saywha90/Bachelor_prosjekt/src/calibration/10_bin_calibration.py

"""
Interactive rear-bin route fine-tuning for real hardware calibration.

This tool edits the production route schema in ``bin_calibration.json`` for the
two physical rear bins only: ``RED_BIN`` and ``BLUE_BIN``.  It intentionally does
not create or save ``REJECT_BIN`` because production should return to scanning
when no object is gripped instead of routing to a reject bin.

The default mode connects to the arm, mirrors the touch-calibration workflow,
and supports explicit hardware movement plus limp-mode pose capture.  Offline
editing and test runs are still available with ``--dry-run``/``--no-hardware``.

Usage
-----
    PYTHONPATH=src python3 src/calibration/10_bin_calibration.py
    PYTHONPATH=src python3 src/calibration/10_bin_calibration.py --port /dev/cu.usbmodem101
    PYTHONPATH=src python3 src/calibration/10_bin_calibration.py --dry-run

Author: Bachelor Project 2026 – Autonomia    
"""

from __future__ import annotations

import argparse
import copy
import json
import os
import sys
import tempfile
import time
from dataclasses import dataclass
from datetime import date
from pathlib import Path
from typing import Any, Callable

sys.path.insert(0, os.path.join(os.path.dirname(os.path.abspath(__file__)), ".."))

import cv2  # noqa: E402
import numpy as np  # noqa: E402

from config.arm import (  # noqa: E402
    BIN_CALIBRATION_FILE as CONFIG_BIN_CALIBRATION_FILE,
    DEFAULT_REAR_ROUTE_BASE_YAW_LIMIT_DEG,
    SCAN_POSE,
    RouteCalibrationError,
    load_transport_route_calibration,
)
from ik.solver import ArmIK  # noqa: E402
from simulation.bin_safety import (  # noqa: E402
    BinVolume,
    SAG_AWARE_BIN_CLEARANCE_CM,
    bin_volumes_from_centres,
    find_claw_bin_point_clearance_violation,
    find_claw_bin_segment_clearance_violation,
    format_claw_bin_clearance_reason,
)


BIN_CALIBRATION_FILE = Path(CONFIG_BIN_CALIBRATION_FILE)
SERIAL_PORT = "/dev/cu.usbmodem101"
SERIAL_BAUD = 115200
MOVE_SETTLE_SECONDS = 0.75
ROUTE_SETTLE_SECONDS = 0.75
LIMP_MOTOR_IDS = (1, 2, 3, 4)
MAX_CAPTURE_M4_OFFSET = 1500
M4_STEPS_PER_REV = ArmIK.STEPS_PER_REV

ROUTE_SCHEMA_VERSION = 4
ONLY_BIN_NAMES = ("RED_BIN", "BLUE_BIN")
SHARED_WAYPOINTS = ("front_neutral", "rear_transfer", "rear_return_lift")
BIN_POSES = ("drop",)
POSE_FIELDS = ("x", "y", "z", "m4_offset")


@dataclass(frozen=True)
class WaypointSpec:
    """Editable route waypoint descriptor."""

    key: str
    title: str
    intent: str
    root: str
    bin_name: str | None = None
    pose_name: str | None = None


EDITABLE_WAYPOINTS = (
    WaypointSpec("front_neutral", "front_neutral", "carry", "shared"),
    WaypointSpec("rear_transfer", "rear_transfer", "rear_place", "shared"),
    WaypointSpec("rear_return_lift", "rear_return_lift", "rear_place", "shared"),
    WaypointSpec("RED_BIN.drop", "RED_BIN.drop", "rear_place", "bin", "RED_BIN", "drop"),
    WaypointSpec("BLUE_BIN.drop", "BLUE_BIN.drop", "rear_place", "bin", "BLUE_BIN", "drop"),
)


def _safe_default_route_schema() -> dict[str, Any]:
    """Return a conservative valid two-bin rear route schema."""

    return {
        "schema_version": ROUTE_SCHEMA_VERSION,
        "calibration_date": date.today().isoformat(),
        "calibrated_with_scan_pose": {k: int(v) for k, v in SCAN_POSE.items()},
        "rear_base_yaw_limit_deg": float(DEFAULT_REAR_ROUTE_BASE_YAW_LIMIT_DEG),
        "shared_waypoints": {
            "front_neutral": {
                "x": 22.0,
                "y": 0.0,
                "z": 30.0,
                "m4_offset": 0,
                "skip_sag": True,
            },
            "rear_transfer": {
                "x": -22.0,
                "y": 0.0,
                "z": 38.0,
                "m4_offset": 0,
                "skip_sag": True,
            },
            "rear_return_lift": {
                "x": -22.0,
                "y": 0.0,
                "z": 42.0,
                "m4_offset": 0,
                "skip_sag": True,
            },
        },
        "bins": {
            "RED_BIN": {
                "drop": {
                    "x": -24.0,
                    "y": -7.0,
                    "z": 37.0,
                    "m4_offset": 0,
                    "skip_sag": True,
                },
            },
            "BLUE_BIN": {
                "drop": {
                    "x": -24.0,
                    "y": 7.0,
                    "z": 37.0,
                    "m4_offset": 0,
                    "skip_sag": True,
                },
            },
        },
    }


def _route_calibration_to_schema(route_calibration: Any) -> dict[str, Any]:
    """Convert a validated config.arm transport route to writable JSON data."""

    def pose_to_dict(pose: Any) -> dict[str, Any]:
        return {
            "x": round(float(pose.x), 2),
            "y": round(float(pose.y), 2),
            "z": round(float(pose.z), 2),
            "m4_offset": int(pose.m4_offset),
            "skip_sag": bool(pose.skip_sag),
        }

    schema = _safe_default_route_schema()
    schema["schema_version"] = max(int(route_calibration.schema_version), ROUTE_SCHEMA_VERSION)
    schema["rear_base_yaw_limit_deg"] = float(
        getattr(
            route_calibration,
            "rear_base_yaw_limit_deg",
            DEFAULT_REAR_ROUTE_BASE_YAW_LIMIT_DEG,
        )
    )
    for waypoint in SHARED_WAYPOINTS:
        schema["shared_waypoints"][waypoint] = pose_to_dict(route_calibration.shared_waypoints[waypoint])
    for bin_name in ONLY_BIN_NAMES:
        bin_route = route_calibration.bins[bin_name]
        schema["bins"][bin_name] = {
            "drop": pose_to_dict(bin_route.drop),
        }
    return schema


def load_or_initialize_route_schema(path: Path = BIN_CALIBRATION_FILE) -> tuple[dict[str, Any], list[str]]:
    """Load current route schema or return a safe two-bin initialization.

    The returned schema is always constrained to ``RED_BIN`` and ``BLUE_BIN``.
    Legacy, missing, incomplete, invalid, or extra-bin files never propagate a
    ``REJECT_BIN`` entry into the editable data.
    """

    messages: list[str] = []
    try:
        route = load_transport_route_calibration(path=path, require_route_schema=True)
        missing_bins = [bin_name for bin_name in ONLY_BIN_NAMES if bin_name not in route.bins]
        if missing_bins:
            raise RouteCalibrationError(f"route schema missing required bin(s): {', '.join(missing_bins)}")
        schema = _route_calibration_to_schema(route)
        messages.append(f"Loaded route schema from {path}")
        if any(bin_name not in ONLY_BIN_NAMES for bin_name in route.bins):
            messages.append("Ignored non-production bin entries while loading; only RED_BIN and BLUE_BIN are editable")
        return schema, messages
    except RouteCalibrationError as exc:
        messages.append(f"Using safe two-bin route defaults because calibration could not be loaded: {exc}")
    except FileNotFoundError as exc:
        messages.append(f"Using safe two-bin route defaults because calibration file is missing: {exc}")

    return _safe_default_route_schema(), messages


def _save_json_atomic(path: Path, data: dict[str, Any]) -> None:
    """Write JSON atomically by replacing with a fully-written temp file."""

    path = Path(path)
    tmp_fd, tmp_path = tempfile.mkstemp(dir=str(path.parent), suffix=".tmp")
    try:
        with os.fdopen(tmp_fd, "w", encoding="utf-8") as f:
            json.dump(data, f, indent=2)
            f.write("\n")
        os.replace(tmp_path, path)
    except BaseException:
        if os.path.exists(tmp_path):
            os.unlink(tmp_path)
        raise


def save_route_schema(data: dict[str, Any], path: Path = BIN_CALIBRATION_FILE) -> None:
    """Save route schema to the main calibration JSON file only."""

    path = Path(path)
    path.parent.mkdir(parents=True, exist_ok=True)
    data_to_save = sanitize_two_bin_schema(data)
    data_to_save["calibration_date"] = date.today().isoformat()
    data_to_save["calibrated_with_scan_pose"] = {k: int(v) for k, v in SCAN_POSE.items()}
    _save_json_atomic(path, data_to_save)


def sanitize_two_bin_schema(data: dict[str, Any]) -> dict[str, Any]:
    """Return a route schema containing only supported two-bin route data."""

    defaults = _safe_default_route_schema()
    sanitized = copy.deepcopy(defaults)
    sanitized["schema_version"] = int(data.get("schema_version", data.get("version", ROUTE_SCHEMA_VERSION)) or ROUTE_SCHEMA_VERSION)
    sanitized["schema_version"] = max(sanitized["schema_version"], ROUTE_SCHEMA_VERSION)
    sanitized["rear_base_yaw_limit_deg"] = _parse_rear_base_yaw_limit(
        data.get("rear_base_yaw_limit_deg", DEFAULT_REAR_ROUTE_BASE_YAW_LIMIT_DEG)
    )

    shared_raw = data.get("shared_waypoints") if isinstance(data.get("shared_waypoints"), dict) else {}
    for waypoint in SHARED_WAYPOINTS:
        if isinstance(shared_raw.get(waypoint), dict):
            sanitized["shared_waypoints"][waypoint] = _sanitize_pose(shared_raw[waypoint], defaults["shared_waypoints"][waypoint])

    bins_raw = data.get("bins") if isinstance(data.get("bins"), dict) else {}
    for bin_name in ONLY_BIN_NAMES:
        raw_bin = bins_raw.get(bin_name) if isinstance(bins_raw.get(bin_name), dict) else {}
        for pose_name in BIN_POSES:
            if isinstance(raw_bin.get(pose_name), dict):
                sanitized["bins"][bin_name][pose_name] = _sanitize_pose(
                    raw_bin[pose_name], defaults["bins"][bin_name][pose_name]
                )
    return sanitized


def _parse_rear_base_yaw_limit(raw: Any) -> float:
    try:
        limit = abs(float(raw))
    except (TypeError, ValueError):
        return float(DEFAULT_REAR_ROUTE_BASE_YAW_LIMIT_DEG)
    if not 0.0 <= limit <= 180.0:
        return float(DEFAULT_REAR_ROUTE_BASE_YAW_LIMIT_DEG)
    return limit


def normalize_replay_m4_offset(raw_offset: int) -> int:
    """Return the nearest signed servo-equivalent wrist replay offset."""

    half_rev = M4_STEPS_PER_REV // 2
    return ((int(raw_offset) + half_rev) % M4_STEPS_PER_REV) - half_rev


def _sanitize_pose(raw_pose: dict[str, Any], default_pose: dict[str, Any]) -> dict[str, Any]:
    pose = copy.deepcopy(default_pose)
    for field in ("x", "y", "z"):
        try:
            pose[field] = round(float(raw_pose.get(field, pose[field])), 2)
        except (TypeError, ValueError):
            pass
    try:
        pose["m4_offset"] = int(raw_pose.get("m4_offset", pose.get("m4_offset", 0)) or 0)
    except (TypeError, ValueError):
        pose["m4_offset"] = int(default_pose.get("m4_offset", 0) or 0)
    pose["skip_sag"] = bool(raw_pose.get("skip_sag", pose.get("skip_sag", True)))
    return pose


def get_waypoint(data: dict[str, Any], spec: WaypointSpec) -> dict[str, Any]:
    """Return the mutable waypoint pose dictionary for a waypoint spec."""

    if spec.root == "shared":
        return data["shared_waypoints"][spec.key]
    if spec.bin_name is None or spec.pose_name is None:
        raise ValueError(f"Invalid bin waypoint spec: {spec}")
    return data["bins"][spec.bin_name][spec.pose_name]


def update_waypoint_field(
    data: dict[str, Any],
    spec: WaypointSpec,
    field: str,
    delta: float,
    *,
    clamp_m4: bool = True,
) -> dict[str, Any]:
    """Apply a small field adjustment to a waypoint and return that waypoint."""

    if field not in POSE_FIELDS:
        raise ValueError(f"Unsupported waypoint field {field!r}; expected one of {POSE_FIELDS}")
    waypoint = get_waypoint(data, spec)
    if field == "m4_offset":
        next_value = int(waypoint.get(field, 0)) + int(round(delta))
        if clamp_m4:
            next_value = max(-1500, min(1500, next_value))
        waypoint[field] = next_value
    else:
        waypoint[field] = round(float(waypoint.get(field, 0.0)) + float(delta), 2)
    return waypoint


def strict_pose_for_validation(data: dict[str, Any], spec: WaypointSpec) -> dict[str, Any]:
    """Build the pose mapping passed to ArmIK.solve_strict()."""

    pose = dict(get_waypoint(data, spec))
    pose.setdefault("m4_offset", 0)
    pose.setdefault("skip_sag", True)
    if spec.intent == "rear_place":
        pose["rear_base_yaw_limit_deg"] = data.get(
            "rear_base_yaw_limit_deg",
            DEFAULT_REAR_ROUTE_BASE_YAW_LIMIT_DEG,
        )
    return pose


def _bin_volumes_for_schema(data: dict[str, Any]) -> tuple[BinVolume, ...]:
    bins_raw = data.get("bins") if isinstance(data.get("bins"), dict) else {}
    centres: dict[str, dict[str, Any]] = {}
    for bin_name in ONLY_BIN_NAMES:
        raw_bin = bins_raw.get(bin_name) if isinstance(bins_raw.get(bin_name), dict) else {}
        drop_pose = raw_bin.get("drop") if isinstance(raw_bin.get("drop"), dict) else None
        if drop_pose is not None:
            centres[bin_name] = drop_pose
    return bin_volumes_from_centres(centres)


def _validate_claw_bin_clearance_for_pose(
    data: dict[str, Any],
    spec: WaypointSpec,
    pose: dict[str, Any],
) -> None:
    violation = find_claw_bin_point_clearance_violation(pose, _bin_volumes_for_schema(data))
    if violation is None:
        return
    reason = format_claw_bin_clearance_reason(
        violation,
        context=f"waypoint {spec.key!r} claw pose",
    )
    raise ValueError(reason)


def _validate_claw_bin_clearance_for_segment(
    data: dict[str, Any],
    previous_spec: WaypointSpec,
    previous_pose: dict[str, Any],
    spec: WaypointSpec,
    pose: dict[str, Any],
) -> None:
    violation = find_claw_bin_segment_clearance_violation(previous_pose, pose, _bin_volumes_for_schema(data))
    if violation is None:
        return
    reason = format_claw_bin_clearance_reason(
        violation,
        context=f"segment {previous_spec.key!r} → {spec.key!r} claw path",
    )
    raise ValueError(reason)


def validate_waypoint(data: dict[str, Any], spec: WaypointSpec, arm: ArmIK | None = None) -> dict[str, Any]:
    """Validate a waypoint with ArmIK.solve_strict() and return a result dict."""

    if arm is None:
        arm = ArmIK(rear_base_yaw_limit_deg=data.get("rear_base_yaw_limit_deg", DEFAULT_REAR_ROUTE_BASE_YAW_LIMIT_DEG))
    pose = strict_pose_for_validation(data, spec)
    try:
        _validate_claw_bin_clearance_for_pose(data, spec, pose)
        solved = arm.solve_strict(pose, intent=spec.intent)
        validation = solved["validation"]
        return {
            "ok": True,
            "reason": "OK",
            "commands": solved["commands"],
            "base_yaw_deg": float(validation["base_yaw_deg"]),
            "branch": validation["ik_branch"],
            "shoulder_deg": float(validation["theta_shoulder_deg"]),
            "validation": validation,
        }
    except ValueError as exc:
        return {
            "ok": False,
            "reason": str(exc),
            "commands": None,
            "base_yaw_deg": None,
            "branch": None,
            "shoulder_deg": None,
            "validation": None,
        }


def validate_all_waypoints(data: dict[str, Any], arm: ArmIK | None = None) -> dict[str, dict[str, Any]]:
    """Validate all editable waypoints."""

    return {spec.key: validate_waypoint(data, spec, arm) for spec in EDITABLE_WAYPOINTS}


def print_validation_result(spec: WaypointSpec, result: dict[str, Any]) -> None:
    """Print concise validation details for one waypoint."""

    if result["ok"]:
        print(f"  ✅ {spec.title}: OK")
        print(f"     base_yaw={result['base_yaw_deg']:.2f}°  branch={result['branch']}  shoulder={result['shoulder_deg']:.2f}°")
        print(f"     commands={json.dumps(result['commands'], sort_keys=True)}")
    else:
        print(f"  ❌ {spec.title}: {result['reason']}")


def print_route_summary(data: dict[str, Any], selected_index: int | None = None) -> None:
    """Show current editable route values."""

    print("\nCurrent rear-bin route calibration")
    print(f"  rear_base_yaw_limit_deg = {float(data.get('rear_base_yaw_limit_deg', DEFAULT_REAR_ROUTE_BASE_YAW_LIMIT_DEG)):.1f}")
    for idx, spec in enumerate(EDITABLE_WAYPOINTS, start=1):
        pose = get_waypoint(data, spec)
        marker = "→" if selected_index == idx - 1 else " "
        print(
            f"{marker} [{idx}] {spec.title:<17} "
            f"x={float(pose['x']):>7.2f}  y={float(pose['y']):>7.2f}  "
            f"z={float(pose['z']):>7.2f}  m4_offset={int(pose.get('m4_offset', 0)):>+5d}  "
            f"skip_sag={bool(pose.get('skip_sag', True))}"
        )


def _open_serial(port: str, baud: int):
    """Open serial connection to the OpenRB bridge."""

    import serial

    print(f"[SERIAL] Opening {port} @ {baud} …")
    ser = serial.Serial(port, baud, timeout=2)
    time.sleep(3)
    boot_msg = ""
    while ser.in_waiting:
        boot_msg += ser.readline().decode(errors="replace").strip() + " "
    if not boot_msg.strip():
        boot_msg = ser.readline().decode(errors="replace").strip()
    print(f"[SERIAL] OpenRB says: {boot_msg.strip()}")
    send_raw_command(ser, {"cmd": "enable_torque"})
    send_raw_command(ser, {"cmd": "set_profile", "vel": 40, "acc": 10})
    return ser


def send_raw_command(ser: Any, command: dict[str, Any]) -> str:
    """Send one JSON command to hardware and return the firmware response."""

    ser.write((json.dumps(command) + "\n").encode())
    return ser.readline().decode(errors="replace").strip()


def read_motor_positions(ser: Any) -> dict[str, int] | None:
    """Read current motor positions from the firmware."""

    response = send_raw_command(ser, {"cmd": "read_pos"})
    try:
        positions = json.loads(response)
    except json.JSONDecodeError:
        print(f"  ❌ Invalid read_pos response: {response}")
        return None
    if not isinstance(positions, dict):
        print(f"  ❌ Unexpected read_pos response: {positions!r}")
        return None
    missing = {"m1", "m2", "m3", "m4"} - set(positions)
    if missing:
        print(f"  ❌ read_pos response missing motor keys: {sorted(missing)}")
        return None
    try:
        return {key: int(value) for key, value in positions.items() if str(key).startswith("m")}
    except (TypeError, ValueError):
        print(f"  ❌ Non-integer motor position in read_pos response: {positions}")
        return None


def _set_current_goals_before_torque_on(ser: Any, positions: dict[str, int] | None = None) -> None:
    """Best-effort snap-back prevention before enabling torque."""

    if positions is None:
        positions = read_motor_positions(ser)
    if positions is not None:
        print(f"  [SAFETY] Setting goal positions to current positions before torque-on: {positions}")
        send_raw_command(ser, positions)


def disable_limp_mode(ser: Any, input_func: Callable[[str], str] = input) -> bool:
    """Disable torque on arm motors 1-4 so the arm can be guided by hand."""

    print("\n🖐️  Limp mode requested.")
    print("  ⚠️  SUPPORT THE ARM before disabling torque; it can fall under gravity.")
    confirm = input_func("  Type LIMP when you are supporting the arm, or anything else to cancel: ").strip()
    if confirm != "LIMP":
        print("  Limp mode cancelled; torque was not changed.")
        return False
    for motor_id in LIMP_MOTOR_IDS:
        response = send_raw_command(ser, {"cmd": "set_torque", "id": motor_id, "enable": False})
        if "ERR" in response.upper():
            print(f"  ⚠️  Motor {motor_id} torque disable warning: {response}")
    print("  🔓 Motors 1-4 are now limp. Guide the arm by hand; use 'capture' or 'lock' when done.")
    return True


def enable_limp_mode(ser: Any) -> bool:
    """Re-enable torque safely by first setting goals to current positions."""

    print("\n🔒 Re-enabling torque safely.")
    try:
        positions = read_motor_positions(ser)
        _set_current_goals_before_torque_on(ser, positions)
        response = send_raw_command(ser, {"cmd": "enable_torque"})
        print(f"  Torque response: {response}")
        print("  ✅ Torque re-enabled; arm should hold its current pose.")
        return True
    except Exception as exc:
        print(f"  ⚠️  Failed to re-enable torque: {exc}")
        print("  ⚠️  Manually support the arm and power-cycle if needed.")
        return False


def capture_current_waypoint(
    data: dict[str, Any],
    spec: WaypointSpec,
    ser: Any,
    arm: ArmIK,
) -> bool:
    """Capture current motor pose with FK and store it in the selected waypoint."""

    positions = read_motor_positions(ser)
    if positions is None:
        print("  Capture failed: current motor positions could not be read.")
        return False

    try:
        fk = arm.forward_kinematics(positions)
    except Exception as exc:
        print(f"  Capture failed: forward kinematics could not convert current motors: {exc}")
        enable_limp_mode(ser)
        return False

    old_pose = copy.deepcopy(get_waypoint(data, spec))
    candidate = copy.deepcopy(old_pose)
    candidate["x"] = round(float(fk["x"]), 2)
    candidate["y"] = round(float(fk["y"]), 2)
    candidate["z"] = round(float(fk["z"]), 2)

    # Compute the saved trim as the final claw pitch's deviation from IK's
    # default straight-down pitch.  ``m4_offset`` participates in IK geometry,
    # so FK-captured limp poses can replay the same XYZ instead of rotating the
    # L3 claw-tip link after the Cartesian solve.
    try:
        raw_offset = int(fk.get("replay_m4_offset", 0))
        normalized_offset = normalize_replay_m4_offset(raw_offset)
        candidate["m4_offset"] = max(
            -MAX_CAPTURE_M4_OFFSET,
            min(MAX_CAPTURE_M4_OFFSET, normalized_offset),
        )
        if normalized_offset != raw_offset:
            print(
                f"  ℹ️  Wrist replay offset normalized from {raw_offset:+d} "
                f"to servo-equivalent {normalized_offset:+d} steps."
            )
        if candidate["m4_offset"] != normalized_offset:
            print(
                f"  ⚠️  Wrist replay offset clipped from normalized {normalized_offset:+d} "
                f"to {candidate['m4_offset']:+d} steps for safety."
            )
    except Exception as exc:
        candidate["m4_offset"] = int(old_pose.get("m4_offset", 0) or 0)
        print(f"  ⚠️  Could not derive wrist trim from strict IK ({exc}); keeping previous m4_offset={candidate['m4_offset']}.")

    get_waypoint(data, spec).clear()
    get_waypoint(data, spec).update(candidate)
    result = validate_waypoint(data, spec, arm)
    print("\nCaptured current pose:")
    print(f"  motors={json.dumps(positions, sort_keys=True)}")
    print(
        f"  fk={{x={candidate['x']:.2f}, y={candidate['y']:.2f}, z={candidate['z']:.2f}, "
        f"pitch={float(fk.get('theta_pitch_deg', 0.0)):+.1f}°, replay_m4_offset={candidate['m4_offset']:+d}}}"
    )
    print_validation_result(spec, result)

    if not result["ok"]:
        get_waypoint(data, spec).clear()
        get_waypoint(data, spec).update(old_pose)
        print("  Capture rejected and reverted because strict IK validation failed.")
        enable_limp_mode(ser)
        return False

    enable_limp_mode(ser)
    print("  ✅ Captured pose stored in memory. Use 'save' to persist it.")
    return True


def send_validated_commands(ser: Any, commands: dict[str, int], *, label: str, settle_seconds: float = MOVE_SETTLE_SECONDS) -> str:
    """Send prevalidated motor commands and wait briefly for motion to settle."""

    print(f"  📍 {label}: commands={json.dumps(commands, sort_keys=True)}")
    response = send_raw_command(ser, commands)
    print(f"     Firmware response: {response}")
    if settle_seconds > 0:
        time.sleep(settle_seconds)
    return response


def maybe_move_hardware(ser: Any, commands: dict[str, int], input_func: Callable[[str], str] = input) -> None:
    """Explicitly confirm before moving the arm to validated motor commands."""

    print("\nHardware move requested.")
    print(f"  Commands: {json.dumps(commands, sort_keys=True)}")
    confirm = input_func("  Type MOVE to send these motor goals, or anything else to cancel: ").strip()
    if confirm != "MOVE":
        print("  Move cancelled; no hardware command sent.")
        return
    send_validated_commands(ser, commands, label="Selected waypoint")


def route_specs_for_bin(bin_name: str) -> list[WaypointSpec]:
    """Return editable waypoint specs in movement order for one rear bin."""

    normalized = bin_name.upper()
    if normalized in {"RED", "RED_BIN"}:
        target = "RED_BIN"
    elif normalized in {"BLUE", "BLUE_BIN"}:
        target = "BLUE_BIN"
    else:
        raise ValueError("expected RED_BIN or BLUE_BIN")
    return [
        EDITABLE_WAYPOINTS[0],
        EDITABLE_WAYPOINTS[1],
        next(spec for spec in EDITABLE_WAYPOINTS if spec.key == f"{target}.drop"),
        EDITABLE_WAYPOINTS[2],
        EDITABLE_WAYPOINTS[0],
    ]


def route_specs_for_selected(spec: WaypointSpec) -> list[WaypointSpec]:
    """Return selected bin route specs, or raise for shared-only selections."""

    if spec.bin_name is None:
        raise ValueError("selected waypoint is shared; use 'test red' or 'test blue'")
    return route_specs_for_bin(spec.bin_name)


def maybe_test_route_hardware(
    data: dict[str, Any],
    *,
    ser: Any,
    arm: ArmIK,
    specs: list[WaypointSpec],
    label: str,
    confirmation: str,
    input_func: Callable[[str], str] = input,
) -> bool:
    """Validate, display, confirm, and move through multiple route waypoints."""

    print(f"\nHardware route test requested: {label}")
    route_commands: list[tuple[WaypointSpec, dict[str, Any]]] = []
    all_ok = True
    for spec in specs:
        result = validate_waypoint(data, spec, arm)
        print_validation_result(spec, result)
        all_ok = all_ok and result["ok"]
        if result["ok"]:
            route_commands.append((spec, result["commands"]))
    if not all_ok:
        print("  Route test refused because one or more waypoints failed strict validation.")
        return False

    print("\n  Movement order:")
    for idx, (spec, commands) in enumerate(route_commands, start=1):
        print(f"    {idx}. {spec.title}: {json.dumps(commands, sort_keys=True)}")
    confirm = input_func(f"  Type {confirmation} to move through these {len(route_commands)} waypoints: ").strip()
    if confirm != confirmation:
        print("  Route test cancelled; no hardware command sent.")
        return False

    send_raw_command(ser, {"cmd": "set_profile", "vel": 40, "acc": 10})
    for spec, commands in route_commands:
        send_validated_commands(ser, commands, label=spec.title, settle_seconds=ROUTE_SETTLE_SECONDS)
    print("  ✅ Route test complete.")
    return True


def _render_hud(
    selected_index: int,
    data: dict[str, Any],
    xyz_step: float,
    m4_step: int,
    dirty: bool,
    hardware: bool,
    status_msg: str = "",
    limp_active: bool = False,
) -> "np.ndarray":
    """Render the black HUD screen for the bin calibration OpenCV window."""

    hud = np.zeros((700, 900, 3), dtype=np.uint8)

    WHITE = (255, 255, 255)
    GREEN = (0, 255, 0)
    YELLOW = (0, 255, 255)
    RED = (0, 0, 255)
    CYAN = (255, 255, 0)
    GRAY = (150, 150, 150)
    ORANGE = (0, 165, 255)

    font = cv2.FONT_HERSHEY_SIMPLEX
    y = 35

    # ── Title bar ──────────────────────────────────────────────────────
    cv2.putText(hud, "BIN CALIBRATION - Route Editor", (20, y),
                font, 0.85, CYAN, 2, cv2.LINE_AA)
    mode_text = "HARDWARE" if hardware else "DRY-RUN"
    mode_color = GREEN if hardware else YELLOW
    cv2.putText(hud, mode_text, (720, y), font, 0.6, mode_color, 2, cv2.LINE_AA)
    if limp_active:
        cv2.putText(hud, "LIMP", (720, y + 25), font, 0.55, RED, 2, cv2.LINE_AA)
    if dirty:
        cv2.putText(hud, "* UNSAVED *", (480, y), font, 0.6, YELLOW, 2, cv2.LINE_AA)

    y += 15
    cv2.line(hud, (20, y), (880, y), GRAY, 1)
    y += 30

    # ── Selected waypoint info ─────────────────────────────────────────
    spec = EDITABLE_WAYPOINTS[selected_index]
    pose = get_waypoint(data, spec)
    cv2.putText(hud, f"Waypoint {selected_index + 1}/{len(EDITABLE_WAYPOINTS)}: {spec.title}",
                (20, y), font, 0.75, YELLOW, 2, cv2.LINE_AA)
    y += 40

    cv2.putText(hud, f"X = {float(pose['x']):>8.2f} cm",
                (40, y), font, 0.65, GREEN, 1, cv2.LINE_AA)
    y += 30
    cv2.putText(hud, f"Y = {float(pose['y']):>8.2f} cm",
                (40, y), font, 0.65, GREEN, 1, cv2.LINE_AA)
    y += 30
    cv2.putText(hud, f"Z = {float(pose['z']):>8.2f} cm",
                (40, y), font, 0.65, GREEN, 1, cv2.LINE_AA)
    y += 30
    cv2.putText(hud, f"m4_offset = {int(pose.get('m4_offset', 0)):>+5d} steps",
                (40, y), font, 0.65, ORANGE, 1, cv2.LINE_AA)
    y += 35

    # ── Step sizes ─────────────────────────────────────────────────────
    cv2.putText(hud, f"XYZ step: {xyz_step:.2f} cm   |   m4 step: {m4_step} steps",
                (40, y), font, 0.55, GRAY, 1, cv2.LINE_AA)
    y += 15
    cv2.line(hud, (20, y), (880, y), GRAY, 1)
    y += 25

    # ── All waypoints overview ─────────────────────────────────────────
    cv2.putText(hud, "All Waypoints:", (20, y), font, 0.55, WHITE, 1, cv2.LINE_AA)
    y += 25
    for idx, wp_spec in enumerate(EDITABLE_WAYPOINTS):
        wp_pose = get_waypoint(data, wp_spec)
        is_selected = (idx == selected_index)
        color = YELLOW if is_selected else GRAY
        marker = ">" if is_selected else " "
        text = (
            f"{marker} [{idx + 1}] {wp_spec.title:<20s} "
            f"x={float(wp_pose['x']):>7.2f}  y={float(wp_pose['y']):>7.2f}  "
            f"z={float(wp_pose['z']):>7.2f}  m4={int(wp_pose.get('m4_offset', 0)):>+5d}"
        )
        cv2.putText(hud, text, (30, y), font, 0.42, color, 1, cv2.LINE_AA)
        y += 22

    y += 5
    cv2.line(hud, (20, y), (880, y), GRAY, 1)
    y += 25

    # ── Keyboard controls ──────────────────────────────────────────────
    cv2.putText(hud, "Keyboard Controls:", (20, y), font, 0.55, WHITE, 1, cv2.LINE_AA)
    y += 25
    ctrl_lines = [
        f"1-{len(EDITABLE_WAYPOINTS)}: Select waypoint       W/S: X (fwd/back)      A/D: Y (left/right)",
        "U/J: Z (up/down)           I/K: m4 (wrist tilt)   [/]: XYZ step size",
        "-/=: m4 step size          M: Move to waypoint     T: Test bin route",
        "L: Toggle limp mode        C: Capture current pose ENTER: Save to file",
        "Q: Quit",
    ]
    for line in ctrl_lines:
        cv2.putText(hud, line, (30, y), font, 0.42, GREEN, 1, cv2.LINE_AA)
        y += 20

    # ── Status message ─────────────────────────────────────────────────
    if status_msg:
        status_y = 680
        display_msg = status_msg[:120]
        cv2.putText(hud, display_msg, (20, status_y), font, 0.5, YELLOW, 1, cv2.LINE_AA)

    return hud


def interactive_loop(
    data: dict[str, Any],
    *,
    hardware: bool = False,
    ser: Any = None,
    input_func: Callable[[str], str] = input,
) -> bool:
    """Run the OpenCV HUD-based visual route editor.  Returns True if saved."""

    WINDOW_NAME = "Bin Calibration"
    XYZ_STEPS = [0.1, 0.25, 0.5, 1.0, 2.0]
    M4_STEPS = [5, 10, 25, 50]

    selected_index = 0
    xyz_step_idx = 2   # starts at 0.5 cm
    m4_step_idx = 2    # starts at 25 steps
    saved = False
    dirty = False
    limp_active = False
    status_msg = "Ready. Press a key to begin."

    arm = ArmIK(rear_base_yaw_limit_deg=data.get("rear_base_yaw_limit_deg", DEFAULT_REAR_ROUTE_BASE_YAW_LIMIT_DEG))

    cv2.namedWindow(WINDOW_NAME)

    try:
        while True:
            xyz_step = XYZ_STEPS[xyz_step_idx]
            m4_step = M4_STEPS[m4_step_idx]
            spec = EDITABLE_WAYPOINTS[selected_index]

            hud = _render_hud(
                selected_index, data, xyz_step, m4_step,
                dirty, hardware, status_msg, limp_active,
            )
            cv2.imshow(WINDOW_NAME, hud)
            key = cv2.waitKey(0) & 0xFF

            status_msg = ""

            # ── Select waypoint 1-N ───────────────────────────────────
            if ord("1") <= key <= ord(str(len(EDITABLE_WAYPOINTS))):
                selected_index = key - ord("1")
                status_msg = f"Selected waypoint {selected_index + 1}: {EDITABLE_WAYPOINTS[selected_index].title}"
                continue

            # ── Movement: W/S → X, A/D → Y, U/J → Z, I/K → m4 ──────
            field_delta: tuple[str, float] | None = None
            if key in (ord("w"), ord("W")):
                field_delta = ("x", XYZ_STEPS[xyz_step_idx])
            elif key in (ord("s"), ord("S")):
                field_delta = ("x", -XYZ_STEPS[xyz_step_idx])
            elif key in (ord("a"), ord("A")):
                field_delta = ("y", XYZ_STEPS[xyz_step_idx])
            elif key in (ord("d"), ord("D")):
                field_delta = ("y", -XYZ_STEPS[xyz_step_idx])
            elif key in (ord("u"), ord("U")):
                field_delta = ("z", XYZ_STEPS[xyz_step_idx])
            elif key in (ord("j"), ord("J")):
                field_delta = ("z", -XYZ_STEPS[xyz_step_idx])
            elif key in (ord("i"), ord("I")):
                field_delta = ("m4_offset", float(M4_STEPS[m4_step_idx]))
            elif key in (ord("k"), ord("K")):
                field_delta = ("m4_offset", float(-M4_STEPS[m4_step_idx]))

            if field_delta is not None:
                field, delta = field_delta
                old_pose = copy.deepcopy(get_waypoint(data, spec))
                update_waypoint_field(data, spec, field, delta)
                result = validate_waypoint(data, spec, arm)
                if not result["ok"]:
                    get_waypoint(data, spec).clear()
                    get_waypoint(data, spec).update(old_pose)
                    status_msg = f"REVERTED: {result['reason'][:90]}"
                else:
                    dirty = True
                    pose = get_waypoint(data, spec)
                    val = pose.get(field, 0)
                    status_msg = f"{field} -> {val} | IK OK"
                    if hardware and ser:
                        try:
                            send_validated_commands(ser, result["commands"], label=spec.title)
                            status_msg = f"Moved to {spec.title}"
                        except Exception as e:
                            status_msg = f"Move error: {e}"
                continue

            # ── Step size: [ / ] for XYZ ──────────────────────────────
            if key == ord("["):
                xyz_step_idx = max(0, xyz_step_idx - 1)
                status_msg = f"XYZ step: {XYZ_STEPS[xyz_step_idx]:.2f} cm"
                continue
            if key == ord("]"):
                xyz_step_idx = min(len(XYZ_STEPS) - 1, xyz_step_idx + 1)
                status_msg = f"XYZ step: {XYZ_STEPS[xyz_step_idx]:.2f} cm"
                continue

            # ── Step size: - / = for m4 ───────────────────────────────
            if key == ord("-"):
                m4_step_idx = max(0, m4_step_idx - 1)
                status_msg = f"m4 step: {M4_STEPS[m4_step_idx]} steps"
                continue
            if key == ord("="):
                m4_step_idx = min(len(M4_STEPS) - 1, m4_step_idx + 1)
                status_msg = f"m4 step: {M4_STEPS[m4_step_idx]} steps"
                continue

            # ── M: Move to current waypoint ───────────────────────────
            if key in (ord("m"), ord("M")):
                if not hardware:
                    status_msg = "DRY-RUN: No hardware. Run without --dry-run."
                    continue
                result = validate_waypoint(data, spec, arm)
                if not result["ok"]:
                    status_msg = f"MOVE REFUSED: {result['reason'][:80]}"
                    continue
                try:
                    send_validated_commands(ser, result["commands"], label=spec.title)
                    status_msg = f"Moved to {spec.title}"
                except Exception as exc:
                    status_msg = f"MOVE ERROR: {exc}"
                continue

            # ── T: Test bin route ─────────────────────────────────────
            if key in (ord("t"), ord("T")):
                if not hardware:
                    status_msg = "DRY-RUN: No hardware. Run without --dry-run."
                    continue
                try:
                    if spec.bin_name is not None:
                        specs = route_specs_for_bin(spec.bin_name)
                    else:
                        status_msg = "Select a bin waypoint (3-4) to test a route."
                        continue
                    all_ok = True
                    route_commands: list[tuple[WaypointSpec, dict[str, Any]]] = []
                    previous_rs: WaypointSpec | None = None
                    previous_pose: dict[str, Any] | None = None
                    for rs in specs:
                        pose = strict_pose_for_validation(data, rs)
                        if previous_rs is not None and previous_pose is not None:
                            _validate_claw_bin_clearance_for_segment(data, previous_rs, previous_pose, rs, pose)
                        r = validate_waypoint(data, rs, arm)
                        all_ok = all_ok and r["ok"]
                        if r["ok"]:
                            route_commands.append((rs, r["commands"]))
                        previous_rs = rs
                        previous_pose = pose
                    if not all_ok:
                        status_msg = "TEST REFUSED: validation failed for one or more waypoints."
                        continue
                    send_raw_command(ser, {"cmd": "set_profile", "vel": 40, "acc": 10})
                    for rs, cmds in route_commands:
                        send_validated_commands(ser, cmds, label=rs.title, settle_seconds=ROUTE_SETTLE_SECONDS)
                    status_msg = f"Route test complete: {spec.bin_name}"
                except Exception as exc:
                    status_msg = f"TEST ERROR: {exc}"
                continue

            # ── L: Toggle limp mode ───────────────────────────────────
            if key in (ord("l"), ord("L")):
                if not hardware:
                    status_msg = "DRY-RUN: Limp mode requires hardware."
                    continue
                if limp_active:
                    enable_limp_mode(ser)
                    limp_active = False
                    status_msg = "Torque re-enabled. Arm holding position."
                else:
                    for motor_id in LIMP_MOTOR_IDS:
                        resp = send_raw_command(ser, {"cmd": "set_torque", "id": motor_id, "enable": False})
                        if "ERR" in resp.upper():
                            print(f"  Warning: Motor {motor_id} torque disable issue: {resp}")
                    limp_active = True
                    status_msg = "LIMP: Motors 1-4 disabled. Support the arm! Press L to lock."
                continue

            # ── C: Capture current physical pose into selected waypoint ──
            if key in (ord("c"), ord("C")):
                if not hardware or ser is None:
                    status_msg = "DRY-RUN: Capture requires hardware."
                    continue
                try:
                    captured = capture_current_waypoint(data, spec, ser, arm)
                except Exception as exc:
                    status_msg = f"CAPTURE ERROR: {exc}"
                    continue
                if captured:
                    dirty = True
                    limp_active = False
                    pose = get_waypoint(data, spec)
                    status_msg = (
                        f"Captured {spec.title}: x={float(pose['x']):.2f} "
                        f"y={float(pose['y']):.2f} z={float(pose['z']):.2f} "
                        f"m4={int(pose.get('m4_offset', 0)):+d} (unsaved)"
                    )
                else:
                    status_msg = "CAPTURE REFUSED: current pose was not stored; see terminal."
                continue

            # ── ENTER: Save calibration ───────────────────────────────
            if key == 13:
                results = validate_all_waypoints(data, arm)
                all_ok = all(r["ok"] for r in results.values())
                if not all_ok:
                    failed = [k for k, r in results.items() if not r["ok"]]
                    status_msg = f"SAVE REFUSED: invalid waypoints: {', '.join(failed)}"
                    continue
                try:
                    save_route_schema(data, BIN_CALIBRATION_FILE)
                    dirty = False
                    saved = True
                    status_msg = f"SAVED to {BIN_CALIBRATION_FILE}"
                except Exception as exc:
                    status_msg = f"SAVE ERROR: {exc}"
                continue

            # ── Q: Quit ───────────────────────────────────────────────
            if key in (ord("q"), ord("Q")):
                if dirty:
                    confirm_hud = np.zeros((200, 500, 3), dtype=np.uint8)
                    cv2.putText(confirm_hud, "Unsaved changes exist!",
                                (20, 60), cv2.FONT_HERSHEY_SIMPLEX, 0.8, (0, 255, 255), 2, cv2.LINE_AA)
                    cv2.putText(confirm_hud, "Y = quit without saving",
                                (20, 110), cv2.FONT_HERSHEY_SIMPLEX, 0.6, (255, 255, 255), 1, cv2.LINE_AA)
                    cv2.putText(confirm_hud, "N = cancel and keep editing",
                                (20, 150), cv2.FONT_HERSHEY_SIMPLEX, 0.6, (255, 255, 255), 1, cv2.LINE_AA)
                    cv2.imshow(WINDOW_NAME, confirm_hud)
                    confirm_key = cv2.waitKey(0) & 0xFF
                    if confirm_key not in (ord("y"), ord("Y")):
                        status_msg = "Quit cancelled."
                        continue
                print("Exiting bin calibration.")
                break
    finally:
        cv2.destroyAllWindows()

    return saved


def build_arg_parser() -> argparse.ArgumentParser:
    """Create CLI parser for the hardware-default bin calibration tool."""

    parser = argparse.ArgumentParser(description="Interactive rear-bin route fine-tuning for RED_BIN and BLUE_BIN only.")
    parser.add_argument("--file", type=Path, default=BIN_CALIBRATION_FILE, help=f"Calibration JSON path (default: {BIN_CALIBRATION_FILE})")
    mode_group = parser.add_mutually_exclusive_group()
    mode_group.add_argument(
        "--hardware",
        dest="hardware",
        action="store_true",
        default=True,
        help="Connect to serial hardware (default). Movement still requires explicit command confirmations.",
    )
    mode_group.add_argument(
        "--dry-run",
        "--no-hardware",
        dest="hardware",
        action="store_false",
        help="Offline editing/validation mode with no serial connection or motor movement.",
    )
    parser.add_argument("--port", default=SERIAL_PORT, help=f"Serial port for hardware mode (default: {SERIAL_PORT})")
    parser.add_argument("--baud", type=int, default=SERIAL_BAUD, help=f"Serial baud for hardware mode (default: {SERIAL_BAUD})")
    parser.add_argument("--validate-only", action="store_true", help="Validate all loaded/initialized waypoints and exit without saving or opening serial.")
    return parser


def parse_args(argv: list[str] | None = None) -> argparse.Namespace:
    """Parse CLI arguments; hardware is enabled unless dry-run/no-hardware is requested."""

    return build_arg_parser().parse_args(argv)


def main(argv: list[str] | None = None) -> int:
    global BIN_CALIBRATION_FILE

    args = parse_args(argv)

    BIN_CALIBRATION_FILE = args.file

    print("╔══════════════════════════════════════════════════════════════╗")
    print("║      REAR BIN ROUTE FINE-TUNING — RED_BIN / BLUE_BIN        ║")
    print("╠══════════════════════════════════════════════════════════════╣")
    print("║  Hardware mode is default: serial opens unless --dry-run used.║")
    print("║  Use limp/capture/lock to hand-guide waypoints like touch cal.║")
    print("║  Saves require explicit SAVE and update bin_calibration.json. ║")
    print("╚══════════════════════════════════════════════════════════════╝")

    data, messages = load_or_initialize_route_schema(BIN_CALIBRATION_FILE)
    for message in messages:
        print(f"[LOAD] {message}")
    print("[LOAD] Editable route is constrained to RED_BIN and BLUE_BIN only.")

    arm = ArmIK(rear_base_yaw_limit_deg=data.get("rear_base_yaw_limit_deg", DEFAULT_REAR_ROUTE_BASE_YAW_LIMIT_DEG))
    results = validate_all_waypoints(data, arm)
    for spec in EDITABLE_WAYPOINTS:
        print_validation_result(spec, results[spec.key])

    if args.validate_only:
        return 0 if all(result["ok"] for result in results.values()) else 1

    ser = None
    try:
        if args.hardware:
            print("[MODE] Hardware mode (default). Use --dry-run or --no-hardware for offline editing.")
            ser = _open_serial(args.port, args.baud)
        else:
            print("[MODE] Dry-run/no-hardware mode. No serial connection will be opened and motors cannot move.")
        interactive_loop(data, hardware=args.hardware, ser=ser)
    except KeyboardInterrupt:
        print("\nInterrupted. Unsaved in-memory edits were not written unless SAVE completed earlier.")
        return 130
    finally:
        if ser is not None:
            try:
                ser.close()
                print("Serial connection closed.")
            except Exception:
                pass
    return 0


if __name__ == "__main__":
    raise SystemExit(main())
