saywha90/Bachelor_prosjekt/(commit log)

2026-01-28 docs: utvid README med systemarkitektur og bruksveiledning
    - Dokumentert systemarkitektur (Raspberry Pi/Python og Arduino/C++)
    - Lagt til oversikt over filstruktur for firmware og kildekode
    - Beskrevet installasjon og oppsett av programvare og maskinvare
    - Forklart konfigurasjon for endring av antall akser
    - Dokumentert teststatus og simulerings-/mock-modus
2026-03-09 feat: Implementer ML-klassifisering og komplett testsystem
    Hovedendringer:
    - Implementert CNN-basert ballklassifisering med MobileNetV2 og transfer learning
    - Lagt til TensorFlow Lite støtte for Raspberry Pi optimalisering
    - Opprettet komplett datainnsamlings- og treningssystem
    Nye moduler:
    - src/vision/ml_classifier.py: ML-klassifiseringsmodul med automatisk fallback til HSV
    - src/vision/train_model.py: Treningsskript med data augmentation og evaluering
    - src/vision/collect_training_data.py: Interaktivt verktøy for datainnsamling
    - src/vision/test_without_camera.py: Simuleringstest for utvikling uten hardware
    Testing og validering:
    - tests/test_requirements.py: Automatisk validering av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
2026-03-20 fix(vision): improve overlay text readability
    - All panel text now white with drop shadow
    - Ball labels: white text on dark box with colored border
    - Circles: black outline for visibility on light backgrounds
    - Panel: semi-transparent background instead of solid black
    [pyvenv.cfg]
2026-04-02 Optimalisert koden til høyere confidence
    [raw_data.csv]
2026-04-14 new branch
    [pyvenv.cfg, raw_data.csv]
2026-04-16 Add Motor 5 (Claw) support across all IK and simulation files
2026-04-17 refactor(detection): overhaul false-positive rejection, replace bounded scan loop, and fix calibration coordinate scaling
    Eliminate misclassified non-ball objects (cubes, milk cartons) by
    introducing polygon vertex counting (≤6 vertices → rejected) and an
    IoU comparison against an ideal circle mask inside the Hough detection
    path. Raise the shape gatekeeping thresholds so that the circularity
    floor moves from 0.60 to 0.82 and aspect-ratio floor from 0.70 to 0.80,
    pushing rectangular objects below the acceptance boundary. Tighten the
    colour ROI validity check so that at least 50 % of sampled pixels must
    meet the stricter sat ≥ 120 / val ≥ 70 criteria before a colour label
    is assigned.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
    [config.py, main.py, vision_bridge.py]
2026-04-21 docs: expand calibration guide and update arm link lengths
    - Restructure README with a phased calibration walkthrough covering
    firmware flashing, joint/sag calibration, HSV tuning, and homography
    setup with per-step scripts, timings, and usage examples
    - Document first-time setup flow so new users can bring up the full
    system in order without missing dependencies between steps
    - Update arm link length constants (L1/L2/L3) with values measured from
    the physical robot on 2026-04-21 for improved IK accuracy
    [config.py, diagnose_motors.py, main.py, mock_serial.py, openrb_bridge.ino, pi_kinematics.py, vision_bridge.py, visualizer.py]
2026-04-22 docs(README): add calibration steps for claw, workspace, and pick test
    Expand calibration guide with three new steps:
    - Step 2b: claw open/close calibration via calibrate_claw.py for
    tuning m5 positions to grip a 50 mm ball
    - Step 6b: camera height and scan region verification via
    verify_workspace.py to validate parallax accuracy and coverage
    - Step 8: end-to-end pick-and-place test via test_pick.py
    Also clarify Step 7 (vision offset) as optional since the homography
    now maps directly to the shoulder frame, with CAMERA_OFFSET defaults
    of 0.0.
2026-04-22 refactor: restructure project layout and rewrite README
    - Rename `src/IK/` module files: `pi_kinematics.py` → `solver.py`,
    flatten `Simu/` into `src/simulation/`
    - Update `.clinerules/orchestrator.md` to reflect new lowercase `src/ik/`
    path and relocated simulator directory
    - Rewrite README.md as a concise overview, delegating hardware and
    architecture details to `docs/architecture.md`
    - Add `M1_CENTRE` constant (1012) in IK solver for the physically
    measured base/shoulder rotation center, distinct from the default
    2048 used by motors 2–5
    - Drop unused `numpy` import from the solver module
2026-04-23 docs: enhance README and update hardware specs to OAK-D S2
    - Add status badges (Python, tests, license, platform) to README
    - Update camera references from OAK-D Lite to OAK-D S2
    - Add calibration warning for first-time hardware runs
    - Clarify max reach with theoretical vs practical workspace radius
    - Simplify installation to single `pip install -e .` command
    - Add link to manual test scripts documentation
    - Add team member and supervisor attribution placeholders
    - Update CHANGELOG description to reflect semantic versioning
2026-04-25 chore: save current work
2026-04-26 feat: add pick-failed recovery with grip verification and timing
    - Add VERIFY_GRIP state with position- and load-based grip checks,
    retrying up to 2 times before skipping on failure
    - Add CycleTimer for per-phase timing instrumentation and session
    averages
    - Add firmware `read_load` command to read Present Load from all
    Dynamixel motors
    - Introduce grip verification config: GRIP_VERIFY_TOLERANCE,
    GRIP_LOAD_THRESHOLD, MAX_PICK_RETRIES, VERIFY_HEIGHT
    - Replace Step 6 homography calibration with touch-based
    09_touch_calibration.py and update docs accordingly
    [03_sag.py, 09_touch_calibration.py, main.py, openrb_bridge.ino, solver.py, vision_bridge.py]
2026-04-26 chore: fix trailing whitespace in main.py docstring
    [main.py]
2026-04-26 docs: update changelog and architecture for fixed scan pose
    Revise documentation to reflect the simplified single-move approach,
    replacing the prior two-step visual servoing and 80% partial-approach
    descriptions. Update CHANGELOG entries for the visual servoing bridge
    and ADR list, remove references to APPROACH_HEIGHT, and clarify that
    calculate_partial_move() is now a test/demo utility per ADR-003.
    [08_pick_test.py, main.py, solver.py]
2026-04-28 docs: update L3 length to 22.0 cm and document touch-cal grabs
    - Update L3 link length from 16.5 cm to 22.0 cm in README and architecture docs to reflect physical arm changes
    - Document new `skip_sag` parameter in IK solver for touch-calibrated grab moves to prevent double sag compensation
    - Add `read_current` firmware command for runtime motor current telemetry
    - Document `compute_grab_height(x, y)` helper that interpolates grab Z from touch-calibration data with formula-based fallback
    - Clarify `GRAB_HEIGHT` is now a formula fallback when calibration data is unavailable
    [02_joints.py, 03_sag.py, 09_touch_calibration.py, main.py, mock_serial.py, openrb_bridge.ino]
2026-04-30 docs: update claw servo to XM430 and tighten red mask saturation
    - Correct claw/gripper (ID 5) servo model from XL430 to XM430 across architecture, calibration, and hardware docs
    - Update servo count summary to XM430 × 3, XM540 × 1, XL430 × 1
    - Document Fix 11 in vision-history: raise red HSV saturation thresholds (50→120 regular, 35→80 dark) and V minimum (10→20) to prevent desk background leakage
    - Apply corresponding firmware update in openrb_bridge.ino
    [02_joints.py, 02c_scan_pose.py, 03_sag.py, 06_homography.py, 08_pick_test.py, 09_touch_calibration.py, check_motor_errors.py]
2026-05-04 fix: improve firmware robustness and camera error handling
    - Add 5s timeout to USB serial wait to prevent boot hang
    - Validate cmd field is a string before strcmp to avoid null deref
    - Increase key buffer size from 4 to 5 bytes for motor ID formatting
    - Validate set_profile parameters (vel, acc) and reject vel=0
    - Restore operating mode and profile after current limit change
    - Fix incorrect Present Current address comment (126 → 146)
    - Raise RuntimeError when OAK-D camera fails to open in context manager
    [02_joints.py, 03_sag.py, 04_hsv_tuner.py, 05_hsv_refine.py, 06_homography.py, 08_pick_test.py, 09_touch_calibration.py]
2026-05-04 refactor: address code-review fixes across vision modules
    Apply code-review fixes to detector, camera, classifier, and stream_debug
    modules to improve thread-safety, correctness, and code quality.
    - detector.py: replace thread-unsafe radius mutation with local vars,
    promote `_SCALE` to class-level `DETECTION_SCALE`, remove dead SVM/
    cache code, fix `Dict[str, any]` typing, swap `np.sqrt` for
    `math.hypot`, hoist `defaultdict` import, rename cumulative stats
    keys, and extract `_coast_track()` helper for Kalman coasting.
    - camera.py: raise `RuntimeError` from `__enter__` on open failure,
    log previously swallowed exceptions in `read()` and
    `get_focal_length_px()`, and fix docstring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
2026-05-04 feat(calibration): add interactive bin position calibration
    Introduce `src/calibration/10_bin_calibration.py` for WASD-driven bin
    coordinate calibration with limp mode, persisting results to
    `bin_calibration.json`.
    Extend `src/config/arm.py` with `load_bin_calibration()`,
    `get_bin_coords()`, and `get_bin_m4_offset()` helpers for dynamic
    lookup of calibrated bin positions, and wire the SORTING/DROPPING
    states in `src/main.py` to use these calibrated coordinates for
    precise ball drop-off.
    Update `docs/fordeling_av_arbeid.md` to document the new calibration
    step, helper functions, and revised ownership/file counts (F: 8→9,
    total: 55→56).
2026-05-05 docs(architecture): document rear fold-over routing and updated arm config
    Update architecture documentation to reflect the new rear sorting bin
    placement strategy using a calibrated fold-over route instead of 180°
    base rotation. Document the strict route solver for production
    prevalidation with base-yaw guard.
    Revise arm configuration details: GRAB_HEIGHT lowered to 2.0 cm as
    formula fallback base, CLEARANCE_HEIGHT reduced to 15.0 cm, and
    production routes now loaded from bin_calibration.json with required
    waypoints (front_neutral, rear_transfer) and per-bin approach/drop
    poses. Add DEFAULT_REAR_ROUTE_BASE_YAW_LIMIT_DEG (45.0°) and clarify
    that REJECT_BIN is not used in production routin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
    [09_touch_calibration.py, 10_bin_calibration.py, main.py, route_demo.py, solver.py]
2026-05-08 refactor(routing): simplify rear transport route and update shoulder height
    - Remove per-bin `approach` waypoints; rear route now goes directly from `rear_transfer` to bin `drop`
    - Add shared `rear_return_lift` waypoint for safe retreat after dropping, ensuring the claw clears the rear bin before facing forward
    - Update `shoulder_height` from 33.0 cm to 35.0 cm to match physical setup
    - Update architecture docs to reflect new route schema and `DROPPING` state behavior
2026-05-09 docs(calibration): document limp-to-WASD safety stop and strict IK behavior
    Add documentation for the new safety check in `09_touch_calibration.py` that
    validates FK X/Y against recorded limp coordinates before entering WASD
    refinement, aborting if the deviation exceeds 1.0 cm. Also update
    troubleshooting docs to reflect that strict IK paths now fail closed on
    joint-limit violations and beyond-max-reach targets instead of silently
    clamping, and refresh `JOINT_LIMITS` line references to match the updated
    solver source.
    [09_touch_calibration.py, 10_bin_calibration.py, bin_safety.py, main.py, mock_serial.py, route_demo.py, solver.py]
2026-05-12 Update calibration, bin safety, claw grip test, and main application
2026-05-19 chore(config): increase MAX_PICK_REACH_CM from 55.0 to 56.0 cm
    Extend the horizontal radial pickup reach limit by 1 cm to allow the arm to attempt pickup motions on objects detected slightly farther from the base.
2026-05-19 chore(calibration): update homography calibration with 13 points
    Recalibrated homography on 2026-05-19, expanding from 9 to 13
    calibration points for improved workspace coverage and accuracy.
    - Updated workspace_px and workspace_cm coordinate mappings
    - Recomputed homography matrix with new point correspondences
    - Extended height_calibration with 4 additional distance/z samples
    - Refreshed wrist_calibration m4_offset values across all points
    - Bumped calibration_date to 2026-05-19
2026-06-12 docs: add demo GIF and video of the arm sorting balls to README
